DreamingXian/FYP-SHIRO/(commit log)

2026-11-04 feat(ward-config): link registered hardware anchors to spatial ward slots with dropdown selection and live status
2026-11-04 feat(bindings): implement searchable comboboxes, unpaired candidate filtering, table search, and 10-item pagination
2026-11-04 feat(ips): implement Phase 1 per-anchor corner reach bounding and Phase 2 3-state IMU kinematic filter with 2s settling convergence
2026-11-04 fix(ward-config): flush wall anchor suggestion, 3D LOS ray-casting with wrist height, ceiling mount, and simulation preview modal
2026-11-04 feat(ips): add multi-topology anchor layout suggestion engine with interactive pattern switcher
2026-11-04 feat(ips): exhaustive combinatorial anchor engine with vertical shadow clearance and obstacle wall mounting
2026-11-04 fix(ips): resolve multi-tag stationary drift, slant range clamp, and add offline dot purge and velocity gating
    [shiro_anchor_node.ino, shiro_wristband_vitals.ino]
2026-11-04 fix(live_map): viewport height containment, designed modal dialog for tag removal, 45cm human dot scaling and velocity-capped smooth movement
2026-11-04 feat(ips): implement 1-click landmark empirical anchor calibration with MySQL persistence
2026-11-04 feat(calibration): add side-by-side reference map preview and reset-to-defaults feature
2026-11-11 feat: complete Quest 3 MR client, clinical alerts, bed docking alignment, and update startup docs
2026-11-11 docs: remove deprecated standalone ESP32-S3 gateway and reflect dual-role anchor architecture
2026-11-11 Add prototype image to README
    Added prototype image to the README.
2026-11-12 test: add unit test runner and extract IPS geometry for testing
    - npm test runs Node's built-in test runner over test/unit
    - Move median, trilateration, room refinement and centroid functions
    from ips_service.js to services/ips/geometry.js unchanged, so they
    can be tested without a database or timers
    - Add 25 unit tests for the Kalman filter, path loss model and geometry
    - Set minimum Node version to 20.12
2026-11-12 fix(security): move anchor Wi-Fi and MQTT settings to git-ignored secrets.h
    - shiro_anchor_node.ino reads SSID, password and broker address from
    secrets.h and stops compiling with a clear message when it is missing
    - Add secrets.example.h as the template
    - Delete the deprecated shiro_gateway_node sketch, which also held
    Wi-Fi credentials
    [secrets.example.h, shiro_anchor_node.ino]
2026-11-13 fix(db): safe start-up, restart-proof data and patient-tagged telemetry
    Database start-up
    - Split the init SQL into database/schema (tables only, now including
    patient_bindings) and database/seed (sample data)
    - Seed data loads only into an empty database; a restart no longer resets
    room sizes, bed and anchor positions or bed status
    - Remove the hard-coded CREATE DATABASE / USE shiro_db so DB_NAME is used
    - initDatabase() throws and server.js exits with code 1 when MySQL is
    unreachable; add 'npm run db:seed'
    Telemetry
    - New services/binding_cache.js maps wristband -> bound patient; vitals and
    trajectories are tagged with the real patient ID, or UNASSIGNED
    - Vitals history is queried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
2026-11-13 fix(alerts): one incident per fall, no invented values, verified vitals alarms
    - Fall de-duplication is registered synchronously per wristband and fall
    counter, so three anchors reporting the same fall create one incident.
    - Unknown impact, stillness, vitals, position, ward and bed are stored as
    NULL. The server and the dashboard no longer fill in sample numbers.
    - The 12 s quiet period applies to vitals alarms only and cannot delay a fall.
    - Vitals rules move to config/clinical_thresholds.js. Extreme readings must
    persist for 5 s; abnormal readings must recur in a second measurement
    cycle or last 30 s. Previously two consecutive packets were enough.
    - Anchor JSON is validated in one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
2026-11-13 fix(firmware): packet v2, +/-8 g fall detection, fault flags, safe anchor table
    Wristband:
    - MPU-6050 set to +/-8 g and verified at boot (the +/-2 g default clipped
    impacts); a failed read raises a fault flag and is never reported as 1.0 g.
    - Fall state machine moved to fall_detector.h: free-fall must last 150 ms,
    peak impact, free-fall minimum and post-impact motion are measured, each
    fall gets a counter. Self-test runs at boot.
    - Vitals accepted in 30-220 BPM and 70-100 % SpO2 so dangerous readings are
    transmitted; heart rate uses the median of the last four beats.
    - Shake-to-wake test hook is behind SHIRO_DEBUG_SHAKE_WAKE (off).
    Anchor:
    - Decodes packet v2, forwards fall and faul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
    [fall_detector.h, shiro_anchor_node.ino, shiro_packet.h, shiro_wristband_vitals.ino, vitals_filter.h]
2026-11-13 feat(alerts): show and store the free-fall minimum of a fall
    The alert pop-up now shows the three values of the wristband's fall
    check (free-fall minimum, impact, post-impact motion), so bench tests
    can be recorded without a USB cable. The free-fall minimum is stored in
    emergency_incident_logs (new nullable column, added by a migration at
    start-up) and named in the alert message.
2026-11-14 fix(firmware): settle 0.5 s after impact before the stillness check, +/-16 g range
    Findings from the bench tests of 14 Nov 2026 (41 recorded falls):
    - The 2 s stillness window started at the impact, so the shock of the
    landing was averaged in as movement. Post-impact motion piled up just
    under the 0.20 g limit and a harder impact was less likely to be
    confirmed. The window now starts 0.5 s after the impact; a fall is
    confirmed 2.5 s after it. Thresholds are unchanged.
    - Most recorded impacts sat on the ceiling values of the +/-8 g range
    (8.0, 11.3, 13.9 g). The accelerometer now runs at +/-16 g, and the
    server accepts totals up to 28 g.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
    [fall_detector.h, shiro_wristband_vitals.ino]
2026-11-14 docs(test): bench test round 1 results and round 2 sheet
    Round 1 (14 Nov 2026): 9 of 10 arm drops detected, no false alarm in 51
    everyday movements, one incident per fall, fault reporting confirmed.
    Records the two findings that led to the settling time and the +/-16 g
    range, and adds the tables for the repeat test.
2026-11-14 fix(alerts): SpO2 display only, unbroken-series vitals rules, no duplicate fall after restart
    Findings from bench round 2 (14 Nov 2026), checked against the stored data:
    - 68 false vitals alarms on a healthy tester, 63 of them for SpO2. 68% of
    66,698 stored SpO2 readings were below 90%: the uncalibrated formula is
    not fit to raise alarms. SpO2 is now stored and shown as indicative only
    (vitals.spo2AlarmsEnabled, default false).
    - "Sustained" and "two cycles" were satisfied by two readings with a long
    silence in between (for example before and after a 45 s fall hold). The
    rules now work on unbroken series of abnormal readings.
    - 9 of 13 false "below 40 BPM" runs were the first beat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
    [shiro_wristband_vitals.ino, vitals_filter.h]
2026-11-14 docs(test): bench test round 2 results, findings and round 3 check
    Round 2 (14 Nov 2026): 41 of 47 hard-surface arm drops detected (18 of 20
    after a defective power switch was replaced), 7 of 7 on a soft surface,
    no false alarm in 51 everyday movements, 3 of 6 in the new movement test.
    Records why fall values showed "not reported" (old 16 g server limit),
    the vitals alarm findings and the short check for the follow-up fixes.
2026-11-14 fix(history): vitals trend covers the whole range, in time order
    The history query sorted each stored series separately and kept the first
    500 points of each, so the trend showed only the oldest readings of the
    range (bench test of 14 Nov 2026: readings until 15:58 were stored, the
    trend ended at 15:28) and returned passive and active readings as two
    blocks.
    The trend now returns one median point per interval (10 s for 1 h up to
    2 h for 30 d), merged over all series of the patient and sorted by time.
    Only the listed ranges are answered; any other value gets the default.
    Raw readings stay available to callers inside the server (newest 1000).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
